ThomasFok/MegaFlash/kicad/rev1.0a/README.md

### Differences between Rev 1.0A and 1.0 PCB

- The 3.3V voltage regulator is removed. The bus transceiver is powered by Pico board.
- GPIO 8 and 9 of Pico (reserved for A2 and A3 address lines) are grounded.
- The shape of the board is rectangular.
