ThomasFok/MegaFlash/firmware/version.txt

Version 1.0.3 11-Nov-2026 (FWVERSION = $04)
- Fix: Add jmp instruction to xsetmou routine
- Fix: Boot Unidisk 3.5 from Boot Menu

Version 1.0.2 11-Jun-2026 (FWVERSION = $03)
- Fix: ProDOS Driver Status command returned wrong drive capacity

Version 1.0.1 08-Mar-2026 (FWVERSION = $02)
- Reduce memory usage in SLOTROM
- Jump to boot menu via swjmp routine
- Optimize readoneblock and writeoneblock routines
- Move dispatch to ROM1 segment
- Move getdib to ROM1 segment
- FPU: Unroll data transfer routine to improve performance

Version 1.0 13-Jul-2025 (FWVERSION = $01)
- First Public Release
- Switch to Main ROM bank when boot menu is executed.
