ThomasFok/MegaFlash/pico/version.txt

Version 1.1.12 04-Sep-2026
Pico Firmware
- Support ISSI Flash Chips
- Compiled with Pico SDK V2.3

Apple Firmware
- No changes (V1.0.2)

Version 1.1.11 18-May-2026
Pico Firmware
- Compiled with C17 and C++17 standard
- Support Alliance AS25F3512MQ flash chip
- When 6502 reads status register ($C0C0), the request is not forwarded to Pico CPU.
- Bug fix: TFTP failed to restart when blksize option from server is invalid

Apple Firmware
- No changes (V1.0.1)

Version 1.1.10 19-Mar-2026
Pico Firmware
- Fix a bug introduced in V1.1.9: Storage medium I/O error cannot be handled correctly during TFTP Transfer

Apple Firmware
- No changes (V1.0.1)

Version 1.1.9 17-Mar-2026
Pico Firmware
- Control Panel: Ask users to save settings when Esc key is pressed.
- TFTP Download: Convert DOS order image (.dsk or .do) to ProDOS order
- Bug Fix: NTP Update is executed twice when the machine is powered on
- Bug Fix: Memory Leak after TFTP Transfer

Apple Firmware
- No changes (V1.0.1)

Version 1.1.8 11-Mar-2026
Pico Firmware
- FSUB Applesoft BASIC FPU command is added
- Optimized Applesoft FPU routines
- Removed IRQ0 from RP2350 PIO program
- Overclocked RP2350 CPU to 225MHz

Apple Firmware (V1.0.1)
- Optimized disk access speed
- Optimized FPU speed

Version 1.1.7 20-Sep-2025
Pico Firmware
- Refactor flash.c and mediaaccess.c source code
- Source code clean up to reduce memory usage
- Improved some prompt messages in XModem Transfer
- RAM Disk has its own dedicated DMA channel

Apple Firmware
- No changes (V1.0)

Version 1.1.6 09-Sep-2025
Pico Firmware
- Optimized the timing of RP2350 PIO for compatibility with slower GAL16V8

Apple Firmware
- No changes (V1.0)

Version 1.1.5 25-Aug-2025
Pico Firmware
- ADTPro VSDRIVE drivers are included in ROM Disk

Apple Firmware
- No changes (V1.0)

Version 1.1.4 18-Aug-2025
Pico Firmware
- Abort Erase Flash Disk if Apple is reset during the process
- Minor clean up of source code

Apple Firmware
- No changes (V1.0)

Version 1.1.3 15-Aug-2025
Pico Firmware
- Bug Fix: Last ProDOS block may contain incorrect data when transferring disk image to PC via XMODEM-1k
- Minor changes to device information output
- Improved SPI reliability by adding NOP to enable/disable_spi0() function
- Changed Mutex in flash.c to Recursive Mutex
- Added Mutex to ramdisk.c
- Show CPU and SPI speed on Device Information Screen

Apple Firmware
- No changes (V1.0)

Version 1.1.2 11-Aug-2025
Pico Firmware
- Set the drive strength of SPI output pins to 8mA
- Set the drive strength of Flash Chips to 75%
- Hide the clock during drive erase in Control Panel
- Bug Fix: System freeze during TFTP Download since V1.1

Apple Firmware
- No changes (V1.0)

Version 1.1.1 04-Aug-2025
Pico Firmware
- Recompiled with PICO SDK V2.2.0
- Minor changes to Control Panel UI Wording
- Changed Pico PIO output pins from pull-down to pull-up for Rev1.1 PCB

Apple Firmware
- No changes (V1.0)

Version 1.1 30-Jul-2025
Pico Firmware
- Bug Fix: Failed to download to RAM Disk via WIFI/TFP
- Bug Fix: Failed to detect of IO Error when TFTP Download
- Improved SPI Interface Reliability
- Option to erase the entire drive when formatting through the Control Panel
- Each drive can be individually enabled/disabled

Apple Firmware
- No changes (V1.0)

Version 1.0 21-Jul-2025
- First Public Release
- Supported Winbond W25Q02JV-DTR flash chip
