ThomasFok/MegaFlash/kicad/rev1.2/bom-rev1.2.pdf

Reference | Value | Qty | Description | Manufacturer | Mfr Part No | Mouser Part No
C1,C2,C3,C4,C5,C6,C7,C8,C9 | 0.1uF | 9 | Ceramic Capacitor, 5mm Lead Spacing | Vishay | K104K15X7RF5WH5 | 594-K104K15X7RF5WH5
D1 | 1N5817 | 1 | 20V 1A Schottky Barrier Rectifier Diode, DO-41 | Vishay | 1N5817-E3/53 | 625-1N5817-E3/53
J1 | EXPSLOT | 1 | 2 Row Pin Header 2.54mm Pitch 19mm Length | Samtec | TSW-117-15-G-D | 200-TSW11715GD
R1,R2 | 100k | 2 | 100k 1/4W Through Hole Resistor
U1,U2 | 74LVC8T245 | 2 | Dual Supply Bus Transceiver, SOIC-24 | TI | SN74LVC8T245DWR | 595-SN74LVC8T245DWR
U3,U4,U5 | 74HC138 | 3 | Decoder 3 to 8 active low outputs | TI | SN74HC138QDRG4Q1 595-SN74HC138QDRG4Q1
U6 | Pico 2W | 1 | Raspberry Pi Pico 2W | Raspberry Pi
U7,U8 | W25Q01JVSF | 2 | SPI NOR Flash 1Gbit, SOIC-16 | Winbond | W25Q01JVSFIM | 454-W25Q01JVSFIM

Note: One Winbond W27C257 or W27E257 EEPROM is needed to replace the system ROM.
