ThomasFok/MegaFlash/kicad/rev1.0a/bom-rev1.0a.pdf

Reference | Value | Qty | Description | Manufacturer | Mfr Part No | Mouser Part No
C1,C2,C3,C4,C5,C6 | 0.1u | 6 | 0805 Ceramic Capacitor | KEMET | C0805C104M5RACTU | 80-C0805C104M5R
D1 | SS12 | 1 | 20V 1A Schottky Diode, SMA | Vishay | SS12-E3/61T | 625-SS12-E3
J1 | EXPSLOT | 1 | 2 Row Pin Header 2.54mm Pitch 19mm Length | Samtec | TSW-117-15-G-D | 200-TSW11715GD
RN1 | 100k | 1 | 4 resistor network, 4x0603 | Panasonic | EXB-V8V104JV | 667-EXB-V8V104JV
U1 | 74LVCH16T245DLR | 1 | 16-Bit Dual-Supply Bus Transceiver | T.I. | SN74LVCH16T245DLR | 595-SN74LVCH16T245LR
U2 | GAL16V8 | 1 | GAL16V8 PLCC-20 Package | Lattice
U3 | Pico | 1 | Raspberry Pi Pico 2W | Raspberry Pi
U4,U5 | W25Q01JVZE | 2 | 128MB NOR Flash, WSON-8 Package | Winbond | W25Q01JVZEIM E | 454-W25Q01JVZEIMTU

Note:
One Winbond W27C257 or W27E257 EEPROM is needed to replace the system ROM.
It is recommended to install a SMD PLCC-20 socket (Mouser part no: 540-88-020-17-400-TR) to U2.
