ThomasFok/MegaFlash/kicad/rev1.2/schematic-rev1.2.pdf

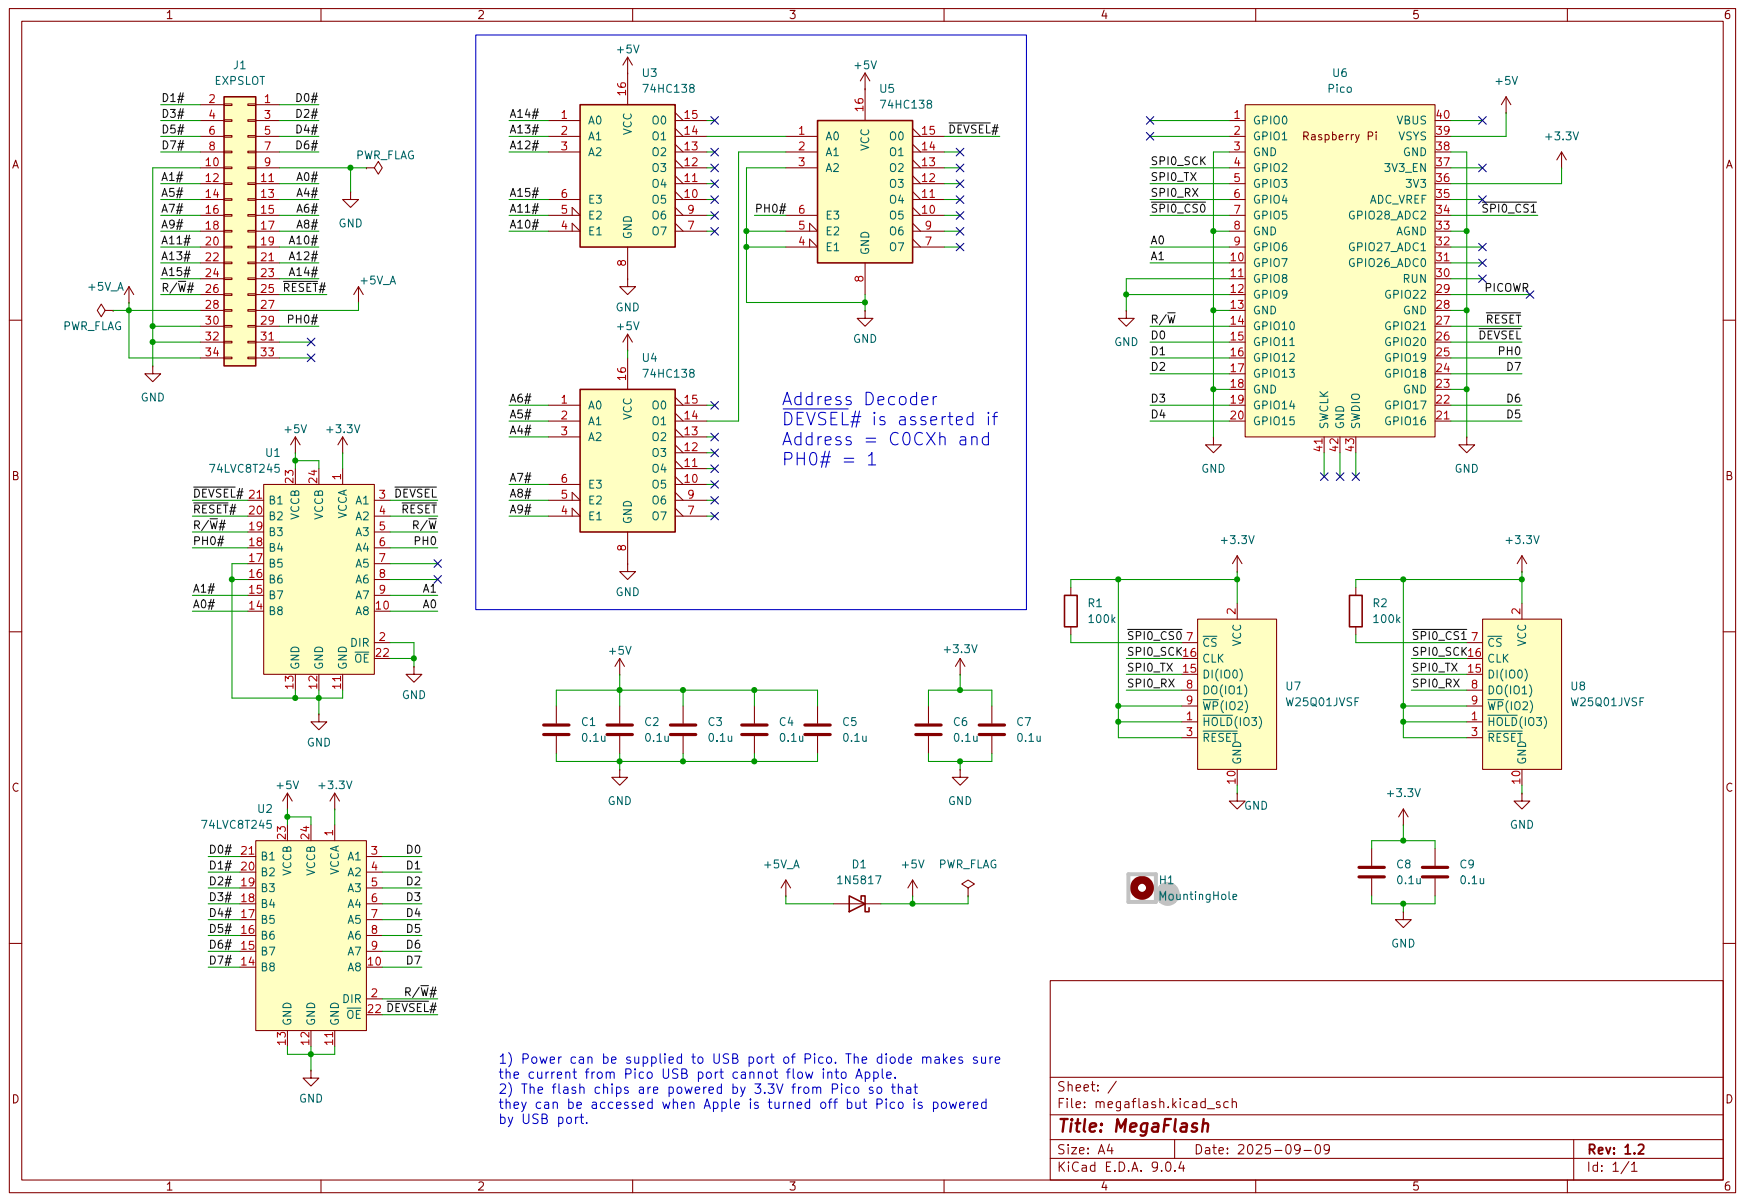
[picture p17: page 1]
