ThomasFok/MegaFlash/kicad/rev1.0a/schematic-rev1.0a.pdf

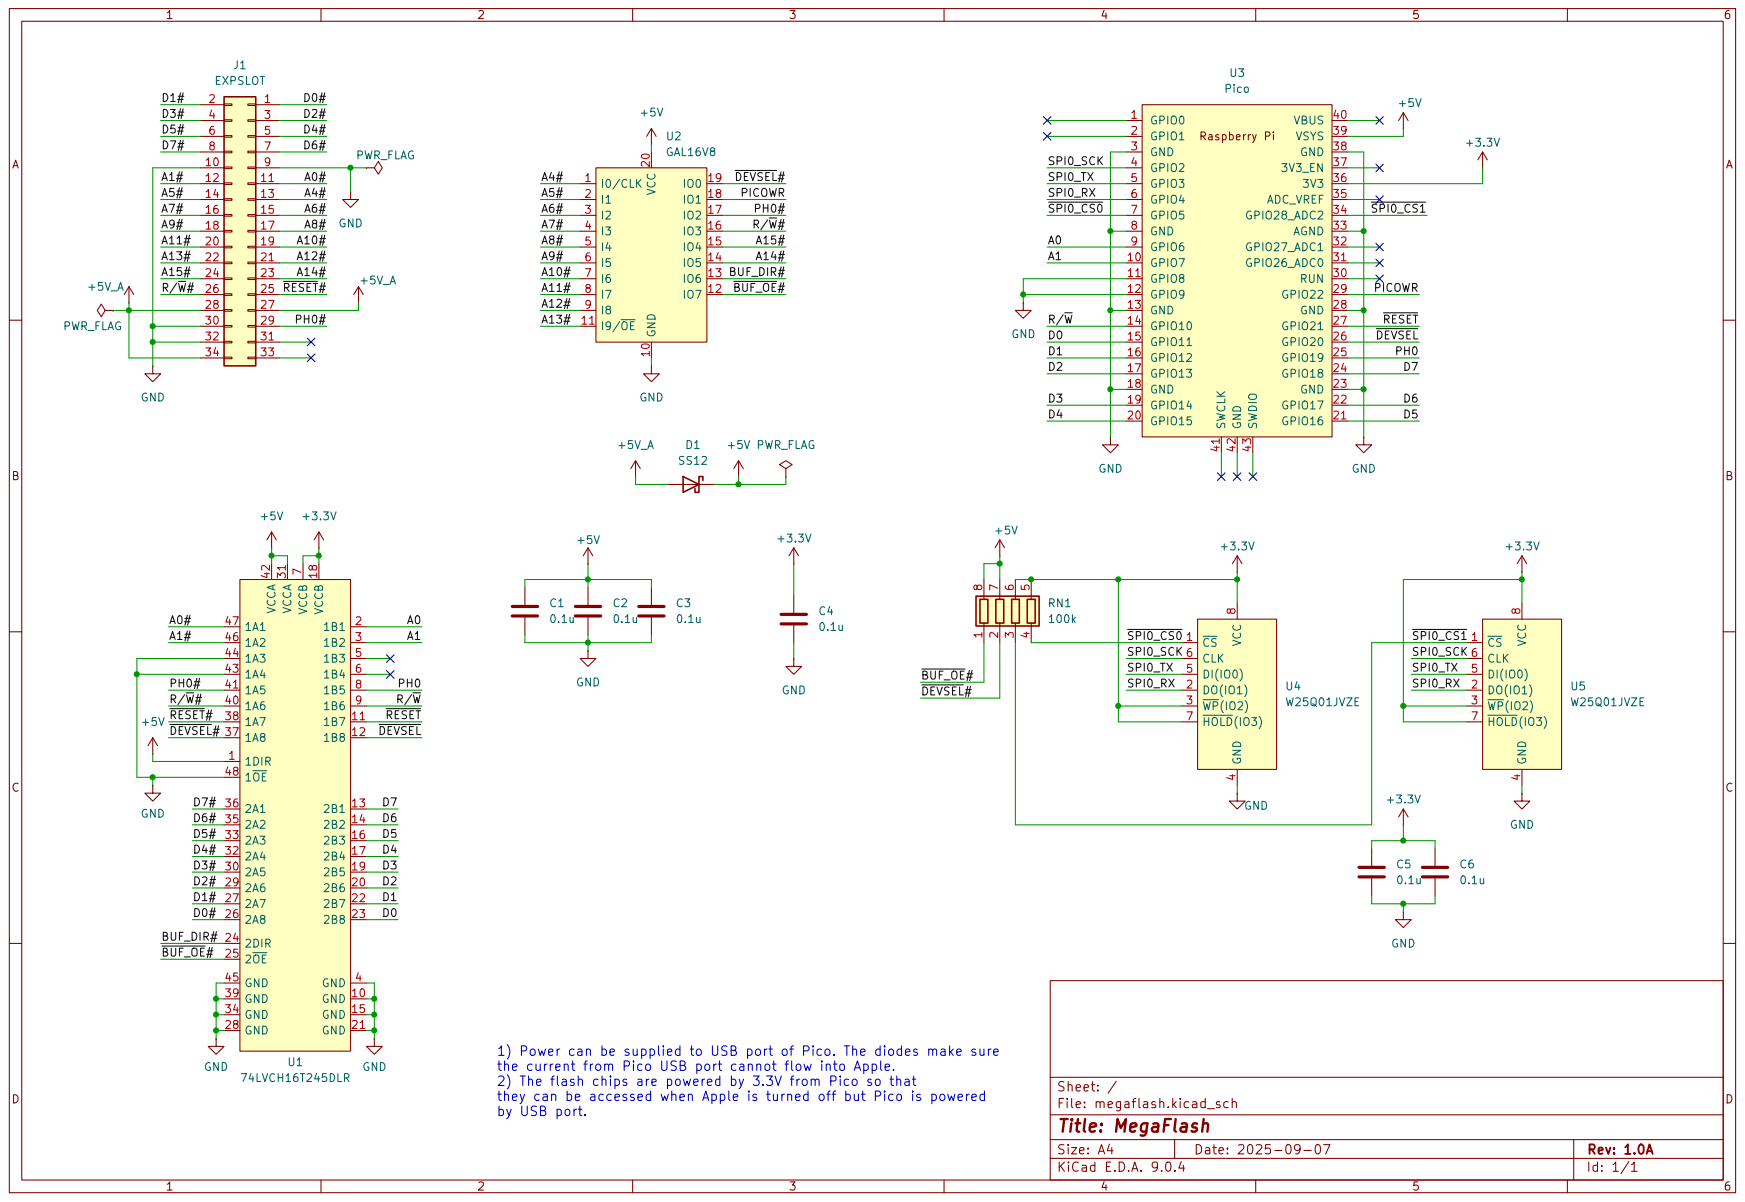
[picture p18: page 1]
