ThomasFok/MegaFlash/kicad/rev1.1b/schematic-rev1.1b.pdf

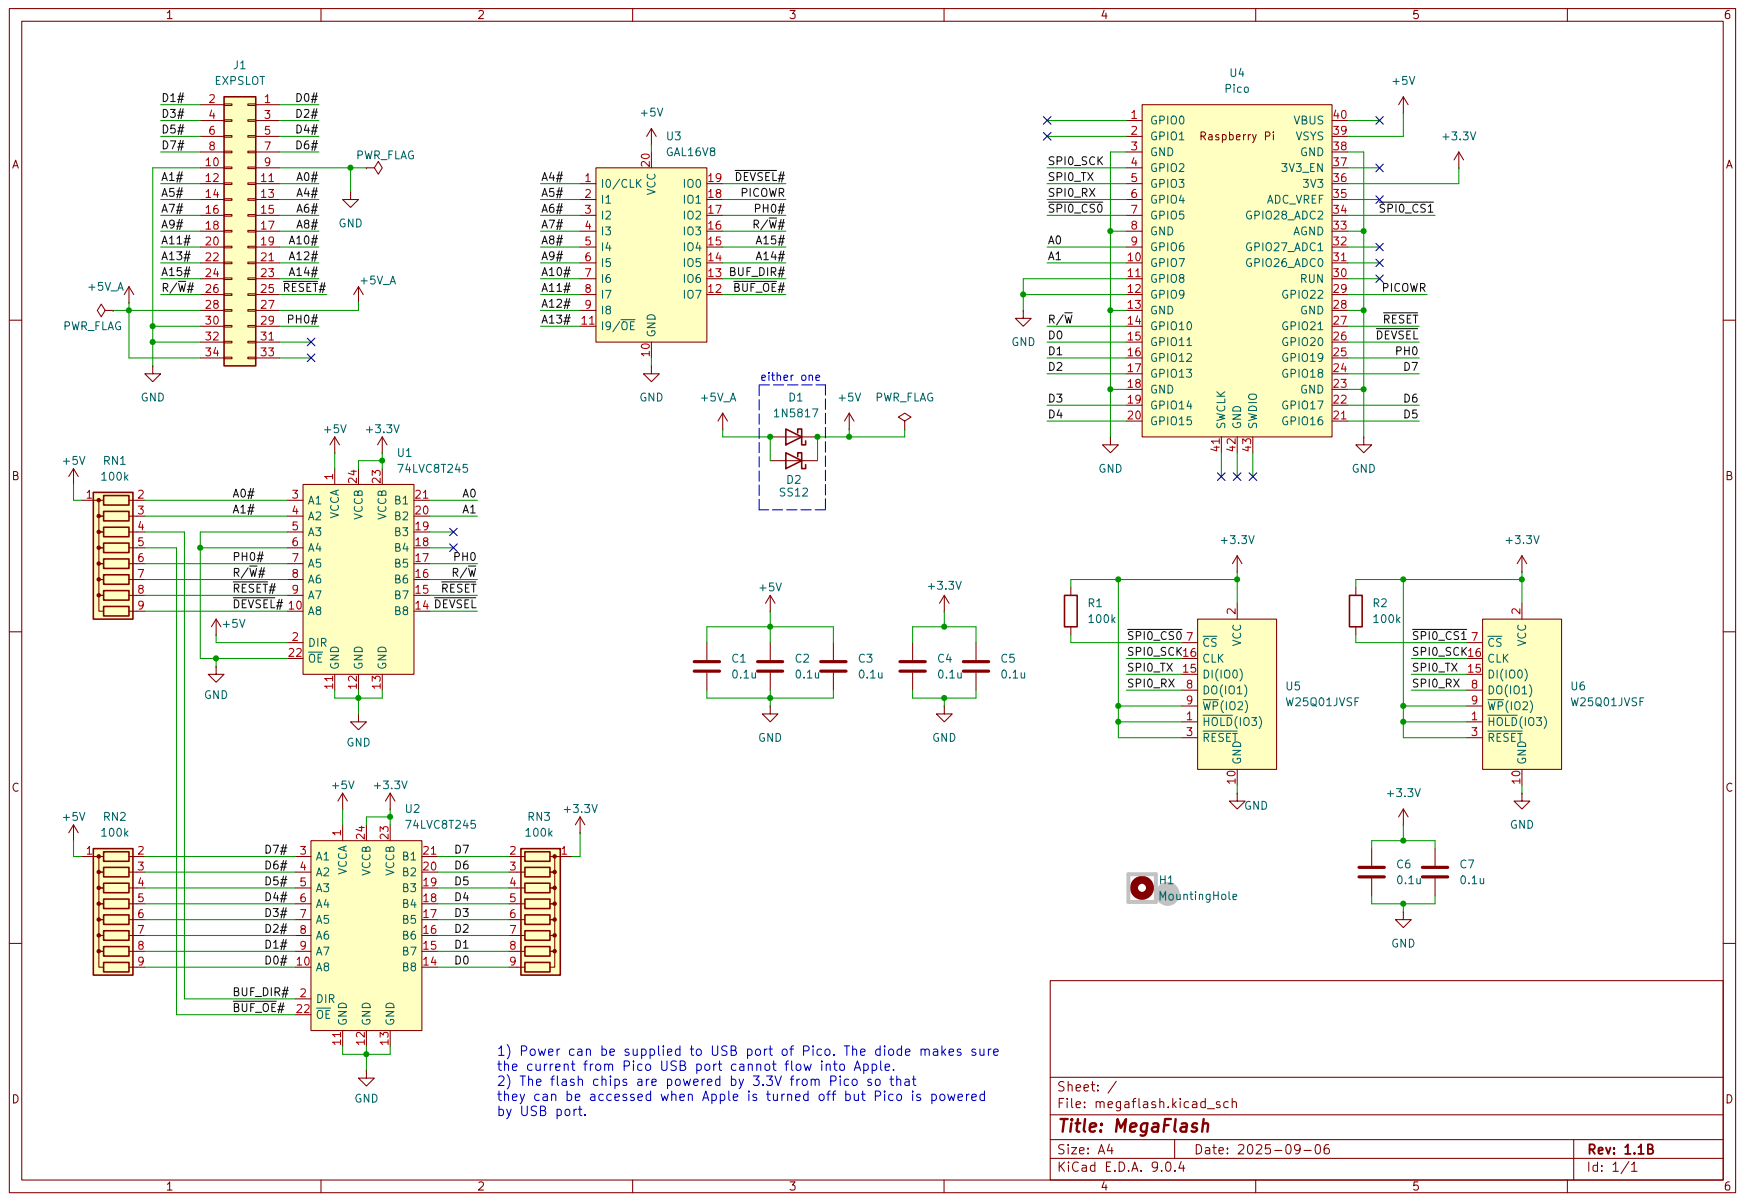
[picture p19: page 1]
