ThomasFok/MegaFlash/kicad/rev1.2/megaflash.kicad_pcb

## KiCad design kicad/rev1.2/megaflash.kicad_pcb (2026-05-17)

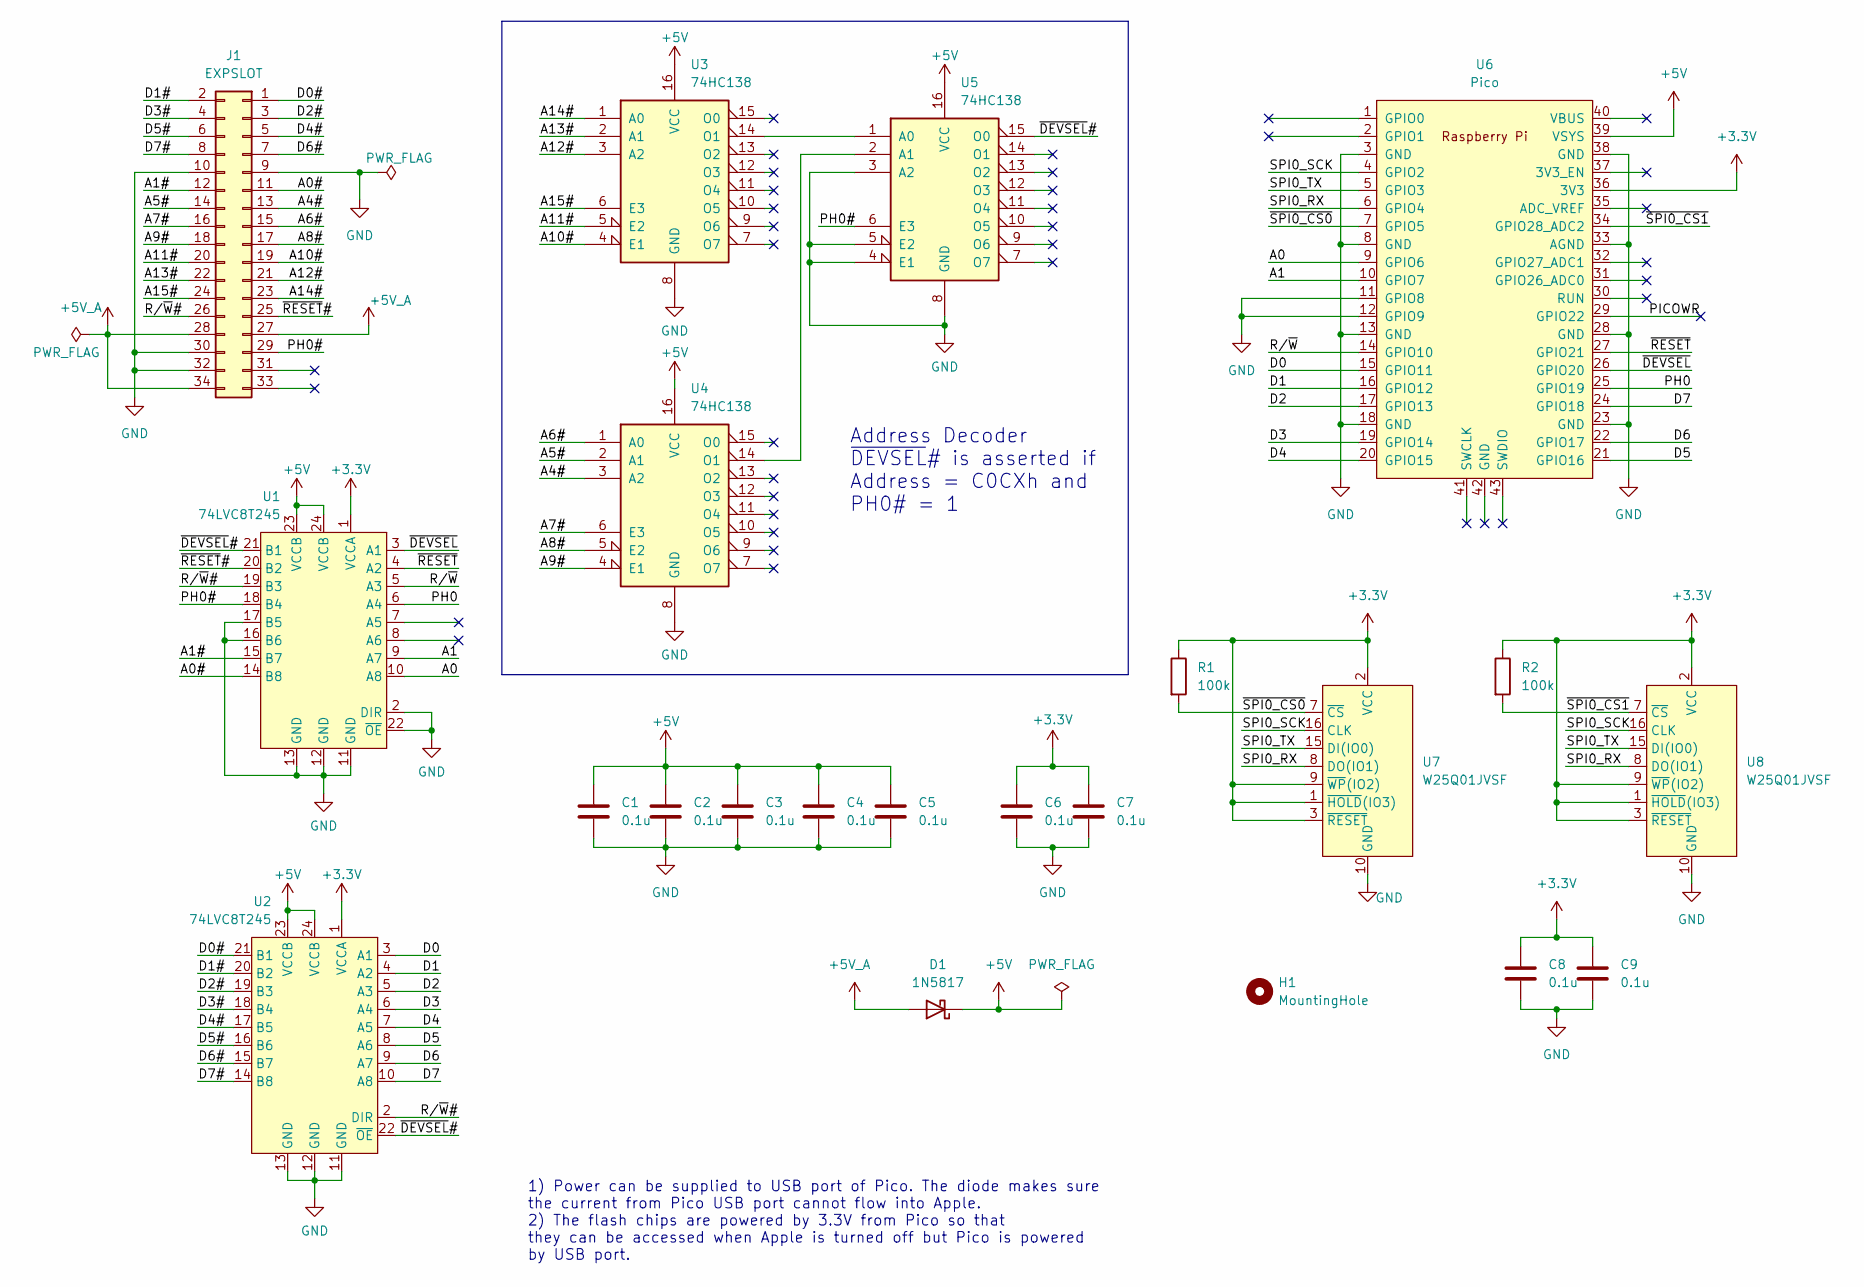
[picture p20: schematic megaflash.kicad_sch]

Parts:
C1, C2, C3, C4, C5, C6, C7, C8, C9: 0.1u; C_Disc_D5.1mm_W3.2mm_P5.00mm; Mouser Part No 594-K104K15X7RF5WH5
D1: 1N5817; D_DO-41_SOD81_P10.16mm_Horizontal; Mouser Part No 625-1N5817-E3/53
H1: MountingHole; MountingHole_2.7mm_M2.5
J1: EXPSLOT; PinHeader_2x17_P2.54mm_Vertical_Mirror; Mouser Part No 200-TSW11715GD
R1, R2: 100k; R_Axial_DIN0207_L6.3mm_D2.5mm_P10.16mm_Horizontal
U1, U2: 74LVC8T245; SOIC-24W_7.5x15.4mm_P1.27mm; Mfr Part No SN74LVC8T245DWR; Mouser Part No 595-SN74LVC8T245DWR
U3, U4, U5: 74HC138; SOIC-16_3.9x9.9mm_P1.27mm; Mouser Part No 595-SN74HC138QDRG4Q1
U6: Pico; RPi_Pico_SMD_NO_LABEL_NO_DEBUG
U7, U8: W25Q01JVSF; SOIC-16W_7.5x10.3mm_P1.27mm; Mouser Part No 454-W25Q01JVSFIM

Connections:
+3.3V: C6.1, C7.1, C8.1, C9.1, R1.1, R2.1, U1.1 (VCCA), U2.1 (VCCA), U6.36 (3V3), U7.1 (~HOLD(IO3)), U7.2 (VCC), U7.3 (~RESET), U7.9 (~WP(IO2)), U8.1 (~HOLD(IO3)), U8.2 (VCC), U8.3 (~RESET), U8.9 (~WP(IO2))
+5V: C1.1, C2.1, C3.1, C4.1, C5.1, D1.1 (K), U1.23 (VCCB), U1.24 (VCCB), U2.23 (VCCB), U2.24 (VCCB), U3.16 (VCC), U4.16 (VCC), U5.16 (VCC), U6.39 (VSYS)
+5V_A: D1.2 (A), J1.27, J1.28, J1.34
/A0: U1.10 (A8), U6.9 (GPIO6)
/A0#: J1.11, U1.14 (B8)
/A1: U1.9 (A7), U6.10 (GPIO7)
/A1#: J1.12, U1.15 (B7)
/A4#: J1.13, U4.3 (A2)
/A5#: J1.14, U4.2 (A1)
/A6#: J1.15, U4.1 (A0)
/A7#: J1.16, U4.6 (E3)
/A8#: J1.17, U4.5 (E2)
/A9#: J1.18, U4.4 (E1)
/A10#: J1.19, U3.4 (E1)
/A11#: J1.20, U3.5 (E2)
/A12#: J1.21, U3.3 (A2)
/A13#: J1.22, U3.2 (A1)
/A14#: J1.23, U3.1 (A0)
/A15#: J1.24, U3.6 (E3)
/D0: U2.3 (A1), U6.15 (GPIO11)
/D0#: J1.1, U2.21 (B1)
/D1: U2.4 (A2), U6.16 (GPIO12)
/D1#: J1.2, U2.20 (B2)
/D2: U2.5 (A3), U6.17 (GPIO13)
/D2#: J1.3, U2.19 (B3)
/D3: U2.6 (A4), U6.19 (GPIO14)
/D3#: J1.4, U2.18 (B4)
/D4: U2.7 (A5), U6.20 (GPIO15)
/D4#: J1.5, U2.17 (B5)
/D5: U2.8 (A6), U6.21 (GPIO16)
/D5#: J1.6, U2.16 (B6)
/D6: U2.9 (A7), U6.22 (GPIO17)
/D6#: J1.7, U2.15 (B7)
/D7: U2.10 (A8), U6.24 (GPIO18)
/D7#: J1.8, U2.14 (B8)
/PH0: U1.6 (A4), U6.25 (GPIO19)
/PH0#: J1.29, U1.18 (B4), U5.6 (E3)
/PICOWR: U6.29 (GPIO22)
/R/~W: U1.5 (A3), U6.14 (GPIO10)
/R/~W#: J1.26, U1.19 (B3), U2.2 (DIR)
/SPI0_RX: U6.6 (GPIO4), U7.8 (DO(IO1)), U8.8 (DO(IO1))
/SPI0_SCK: U6.4 (GPIO2), U7.16 (CLK), U8.16 (CLK)
/SPI0_TX: U6.5 (GPIO3), U7.15 (DI(IO0)), U8.15 (DI(IO0))
/~DEVSEL: U1.3 (A1), U6.26 (GPIO20)
/~DEVSEL#: U1.21 (B1), U2.22 (~OE), U5.15 (O0)
/~RESET: U1.4 (A2), U6.27 (GPIO21)
/~RESET#: J1.25, U1.20 (B2)
/~SPI0_CS0: R1.2, U6.7 (GPIO5), U7.7 (~CS)
/~SPI0_CS1: R2.2, U6.34 (GPIO28_ADC2), U8.7 (~CS)
GND: C1.2, C2.2, C3.2, C4.2, C5.2, C6.2, C7.2, C8.2, C9.2, J1.9, J1.10, J1.30, J1.32, U1.2 (DIR), U1.11 (GND), U1.12 (GND), U1.13 (GND), U1.16 (B6), U1.17 (B5), U1.22 (~OE), U2.11 (GND), U2.12 (GND), U2.13 (GND), U3.8 (GND), U4.8 (GND), U5.3 (A2), U5.4 (E1), U5.5 (E2), U5.8 (GND), U6.3 (GND), U6.8 (GND), U6.11 (GPIO8), U6.12 (GPIO9), U6.13 (GND), U6.18 (GND), U6.23 (GND), U6.28 (GND), U6.33 (AGND), U6.38 (GND), U7.10 (GND), U8.10 (GND)
unnamed: U3.14 (O1), U5.1 (A0)
unnamed: U4.14 (O1), U5.2 (A1)

Notes on the sheet:
Address Decoder ~{DEVSEL}# is asserted if Address = C0CXh and PH0# = 1
1) Power can be supplied to USB port of Pico. The diode makes sure the current from Pico USB port cannot flow into Apple. 2) The flash chips are powered by 3.3V from Pico so that they can be accessed when Apple is turned off but Pico is powered by USB port.

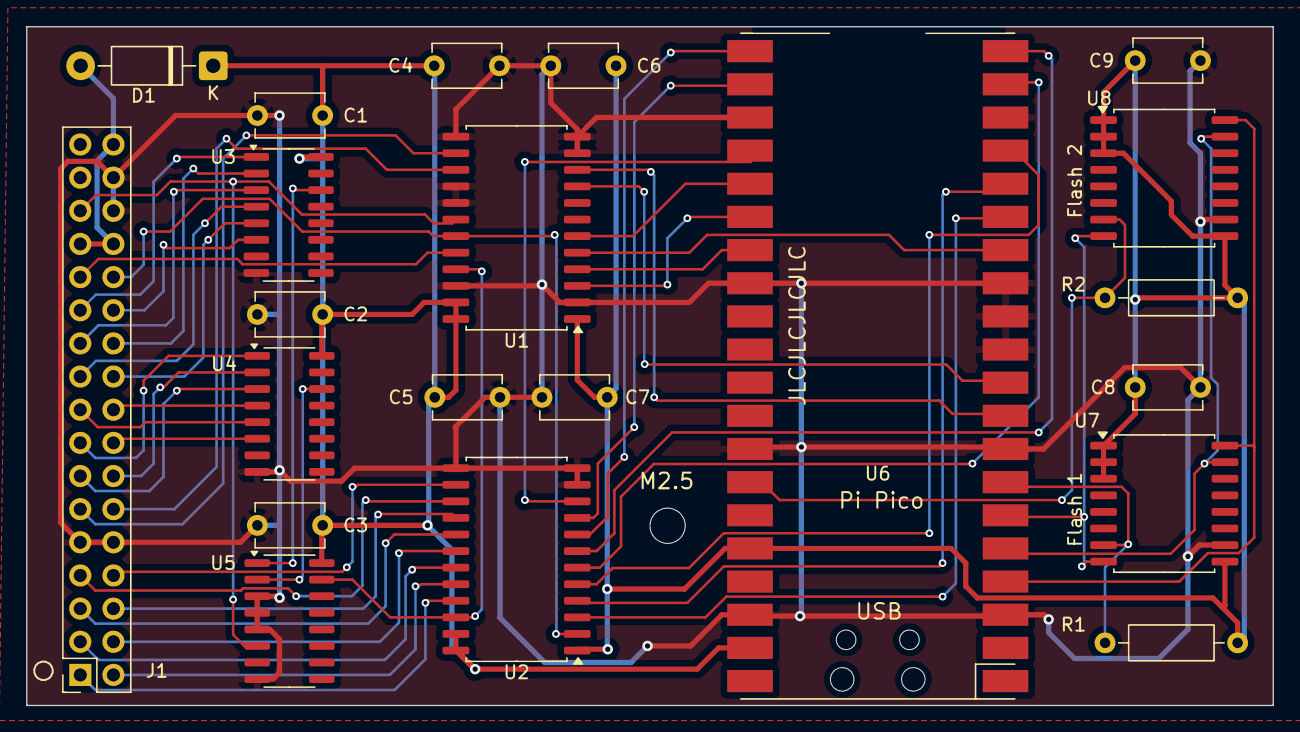
[picture p21: board megaflash.kicad_pcb from above]

Board: 2 copper layers, 95.5 x 52.0 mm, 22 parts (0 on the bottom side), 51 nets.
