ThomasFok/MegaFlash/pico/busloop.c

#include "pico/stdlib.h"
#include "a2bus.h"
#include "defines.h"
#include "busloop.h"
#include "cmdhandler.h"

//--------------------------------------------------------------------
//Accessing buffers from Apple IIc
//The parameter buffer and data buffer can be accessed from address
//$C0C1 and $C0C2. There are internal address pointers in MegaFlash.
//When those addresses are accessed, the pointers advance by one
//automatically. When end of buffer is reached, the pointer loop around
//to the begining of the buffer.
//
//Interleaved Mode
//================
//The data buffer is mainly for storing ProDOS data block. The block is 512 bytes
//long, which is two 6502 pages.To access the buffer, read/write loop
//has to be executed twice.
//
//To reduce the loop overhead, interleaved mode is provided for Data Buffer.
//In this mode, the buffer is divided into two parts, $00-$FF and $100-$1FF.
//When the lower part is accessed, the pointer jumps to the same offset of
//of upper part. When the upper part is accessed, it jumps to next offset of
//lower part.
//
//i.e. The sequence of the pointer is
//
// $0 -> $100 -> $1 -> $101 -> $2 ->$102 -> ... -> $FF ->$1FF -> $0
//
//With interleaved mode, there are two memory accesses in each loop iteration and
//loop overhead can be reduced.
//
//This sequence can be generated by this expression:
//  (dataBufferIndex&0x100)?(dataBufferIndex+1)&0xff:dataBufferIndex|0x100;
//
//Important:
// Switching to interleaved mode should be temporary. The mode should be restored
// to linear after data transfer.
//-----

//---------------------------------------------------------------------
//Mega Flash Registers at $C0C0-C0CF
//We can have up to 16 registers if A2 and A3 address lines are connected.
//The 16 registers are divided into 4 chunks. Each PIO state machine is
//responsible for 4 registers. e.g. State machine 0 is responsible for
//$C0C0-$C0C4.
__attribute__((aligned(4))) union {
  uint8_t  r[16];     //Individual 8-bit registers
  uint32_t i32[4];    //Chunks of 4 32-bit registers
} registers;
//---------------------------------------------------------------------

//---------------------------------------------------------------------
// Parameter / Data Buffers
uint parameterBufferIndex;
uint dataBufferIndex;
uint8_t __attribute__((aligned(4))) parameterBuffer[PARAMBUFFERSIZE]; 
uint8_t __attribute__((aligned(4))) dataBuffer[DATABUFFERSIZE];
transfermode_t dataBufferTransferMode;  //Linear or Interleaved mode
//---------------------------------------------------------------------


////////////////////////////////////////////////////////////////////
// Initialize Bus Loop data
//
void BusLoopDataInit() { 
  //Switch PIO program from Slinky to Native mode
  PioSwitchToNativeMode();

  parameterBufferIndex = 0;
  dataBufferIndex = 0;
  dataBufferTransferMode = DEFAULTTRANSFERMODE;

  registers.r[IDREG] = IDREG_VAL;
  registers.r[STATUSREG]=0;
  registers.r[PARAMREG]=parameterBuffer[0];
  registers.r[DATAREG]=dataBuffer[0];
  registers.i32[1] = 0;
  registers.i32[2] = 0;  
  registers.i32[3] = 0; 
  
  //Send MegaFlash Registers to PIO
  UpdateMegaFlashRegisters(0,registers.i32[0]);
  UpdateMegaFlashRegisters(1,registers.i32[1]);
  UpdateMegaFlashRegisters(2,registers.i32[2]);  
  UpdateMegaFlashRegisters(3,registers.i32[3]);
}

////////////////////////////////////////////////////////////////////
// MegaFlash Bus Loop
//
// Process bus access from Apple II.
// The GetAppleBusBlocking() function waits for bus access from Apple II.
// When it happens, the function sends back the bus access data.
// It includes 4-bit address, 1 bit RnW Flag and 8-bit data for write access.
// The 4-bit address indicates which I/O register is being accessed ($C0C0-$C0CF)
//
// To update the I/O register output value, put the value to registers union.
// For example, to change register $C0C2 to $12. Write $12 to register.r[02].
// The UpdateMegaFlashRegisters() function call at the end of this function
// send updated values to PIO.
//
void __no_inline_not_in_flash_func(BusLoop)() {
  const uint32_t READFLAG = (1<<4); //Read flag is at bit 4

  while(true) {
    //8-bit data from Apple + RnW Flag + 4-bit address from Apple
    const uint32_t busdata = GetAppleBusBlocking();
    const uint32_t addr = busdata & 0b1111;     //Lower nibble of Apple Address

    if (busdata & READFLAG) {
      //
      //6502 is reading from us
      //
      switch(addr) {
        case STATUSREG:
          continue; //No need to update MegaFlsh Registers
        case DATAREG:
          //advance dataBufferIndex
          if (dataBufferTransferMode==MODE_LINEAR) dataBufferIndex = (dataBufferIndex + 1) & DATABUFFERINDEXMASK; //loop around if end of buffer is reached
          else dataBufferIndex = (dataBufferIndex&0x100)?(dataBufferIndex+1)&0xff:dataBufferIndex|0x100;
          
          registers.r[DATAREG] = dataBuffer[dataBufferIndex];
          break;
        case PARAMREG:
          parameterBufferIndex = (parameterBufferIndex + 1) & PARAMBUFFERINDEXMASK; //loop around if end of buffer is reached
          registers.r[PARAMREG] = parameterBuffer[parameterBufferIndex];
          break;        
        case IDREG: 
          registers.r[IDREG] = ~registers.r[IDREG];  //Bitwise NOT
          break;          
        default:
          continue; //No need to update MegaFlash Registers if reading other addresses
      }
      
    } else {
        //
        //6502 is writing to us
        //
        const uint32_t data = (busdata >>5) & 0xff; //8-bit data from Apple
        
        switch(addr) {
          case CMDREG:
            //Set Busy Flag
            registers.r[STATUSREG] |= BUSYFLAG;
            
            //Send Busy Flag to PIO State Machine immediately
            UpdateMegaFlashRegisters(0, registers.i32[0]);

            //Execute the command
            DoCommand(data);
            
            //Clear Busy Flag
            registers.r[STATUSREG] &= ~BUSYFLAG;
            break;
          case DATAREG:
            dataBuffer[dataBufferIndex] = data;
            
            //advance dataBufferIndex
            if (dataBufferTransferMode==MODE_LINEAR) dataBufferIndex = (dataBufferIndex + 1) & DATABUFFERINDEXMASK; //loop around if end of buffer is reached
            else dataBufferIndex = (dataBufferIndex&0x100)?(dataBufferIndex+1)&0xff:dataBufferIndex|0x100;
            
            registers.r[DATAREG] = dataBuffer[dataBufferIndex];
            break;
          case PARAMREG:
            parameterBuffer[parameterBufferIndex] = data;
            parameterBufferIndex = (parameterBufferIndex + 1) & PARAMBUFFERINDEXMASK;
            registers.r[PARAMREG] = parameterBuffer[parameterBufferIndex];
            break;      
          case IDREG:
            break;    //Do nothing. IDREG is not writable.
          default:
            //$C0C4-$C0CF behave like RAM
            registers.r[addr]=data;
            break;
      } 
    } 
    
    //Update MegaFlash I/O registers
    UpdateMegaFlashRegisters(0,registers.i32[0]);
    UpdateMegaFlashRegisters(1,registers.i32[1]);
    UpdateMegaFlashRegisters(2,registers.i32[2]);
    UpdateMegaFlashRegisters(3,registers.i32[3]);    
  }//while  
}
