ThomasFok/MegaFlash/pico/udptask.h

#ifndef _UDPTASK_H
#define _UDPTASK_H

#include "pico/stdlib.h"
#include "pico/cyw43_arch.h"
#include "debug.h"
#include "ringqueue.h"
#include <memory>

static constexpr uint32_t DEFAULT_DNSTIMEOUT = 5000;    //DNS timeout in msec
static constexpr uint32_t UDP_BUFFERSIZE = 1500;        //UDP Packet Buffer Size
static constexpr uint32_t HEARTBEAT_PERIOD = 50;        //Execute event loop every HEARTBEAT_PERIOD in msec
static constexpr uint32_t WATCHDOG_TIMEOUT = (10*1000); //Watchdog Timer timeout in msec
static constexpr size_t   PACKETQUEUE_SIZE = 8;         //Rx Packet Queue Capacity

#define TIMEOUT_NEVER at_the_end_of_time
enum {
  DNSERR_TIMEOUT     = -1,
  DNSERR_NONE        =  0,
  DNSERR_INVALIDHOST =  1
};

//A helper struct to hold the custom deleter function of struct pbuf*
struct pbuf_deleter_t {
	void operator()(struct pbuf* pbuf) 	{
    if (pbuf != nullptr) {
      cyw43_arch_lwip_begin();
      pbuf_free(pbuf);
      cyw43_arch_lwip_end();
    }    
	}
};

//unique_ptr of struct pbuf* with custom deleter
using unique_ptr_pbuf_t = std::unique_ptr<struct pbuf, pbuf_deleter_t>;

//Encapsulate a received UDP packet
struct RxPacket {
	RxPacket() {}
	explicit RxPacket(unique_ptr_pbuf_t& pbuf, ip_addr_t remoteipaddr, uint16_t remoteport)
		:rxpbuf(std::move(pbuf)), rxremoteipaddr(remoteipaddr), rxremoteport(remoteport) {}
    
	//Disallow Copying since unique_ptr is not copyable
	RxPacket(const RxPacket& other) = delete;
	RxPacket& operator=(const RxPacket& other) = delete;

	//Move Constructor and Assignment
	RxPacket(RxPacket&& other) = default;
	RxPacket& operator=(RxPacket&& other) = default;

	unique_ptr_pbuf_t rxpbuf;
	ip_addr_t rxremoteipaddr;
	uint16_t  rxremoteport;
};

//PakcetQueue typedef
using PacketQueue = ringqueue<RxPacket, PACKETQUEUE_SIZE>;

class CUDPTask {
public:
  //Constants
  static const uint32_t WIFI_COUNTRY = CYW43_COUNTRY_WORLDWIDE;
  static const int WIFI_MAX_ATTEMPT = 3;

  //Error Code 0-15 is reserved for CUDPTask
  static const int ERR_NONE       = 0;
  static const int ERR_NOTPICOW   = 1;
  static const int ERR_SSIDNOTSET = 2;
  static const int ERR_NONET      = 3;        //No matching SSID
  static const int ERR_BADAUTH    = 4;        //Authentication Problem
  static const int ERR_NOIP       = 5;        //DHCP problem
  static const int ERR_WIFINOTCONNECTED = 6;  //Other Problems
  static const int ERR_CONNECTIONLOST   = 7;  //WIFI is disconnect during the process
  static const int ERR_DNSINVALIDHOST   = 8;  //Hostname is invalid or does not exist
  static const int ERR_DNSTIMEOUT       = 9;  //Timeout during DNS Lookup
  static const int ERR_WATCHDOG         = 10; //Watchdog Timer timeout
  static const int ERR_ABORTED          = 11; //Aborted by request
  
  //Error Code 16-31 is for subclass
  static const int ERR_SUBCLASS_BEGIN  = 16;

  //Constructor and Destructor
  CUDPTask();
  virtual ~CUDPTask();  /* must be virtual since this is a base class */

  //Disallow copying
  CUDPTask(const CUDPTask&) = delete;
  CUDPTask& operator=(const CUDPTask& ) = delete;

  //Public Methods
  virtual void Run(const char* ssid, const char* wpakey);

  //Getter methods
  bool GetWifiConnected() const {return this->wifiConnected;}
  bool GetServerIpResolved() const {return this->serverIpResolved;}
  ip_addr_t GetServerAddr() const {return this->server_addr;}
  bool GetCompleted() const {return this->completed;}
  
  //Declare callback functions as friend
  friend void dns_callback(const char *hostname, const ip_addr_t *ipaddr, void *arg);
  friend void udp_recv_callback(void *arg, struct udp_pcb *pcb, struct pbuf *pbuf, const ip_addr_t *remote_addr, u16_t remote_port);
  
protected:
  void InitCyw43();
  bool hasInitedCyw43;
  
  //
  // Wifi Connection
  //
  void ConnectWifi(const char* ssid, const char* wpakey);
  bool wifiConnected;     //To indicate WIFI is connected

  //
  // DNS
  //
  void DNSLookup(const char* hostname,const uint32_t timeout=DEFAULT_DNSTIMEOUT);
  absolute_time_t dnsTimeout;
  ip_addr_t server_addr;  //Sever IP Address
  bool serverIpResolved;  //To indicate Server IP Addr is resolved
  //To recevie result from DNS Callback
  bool dnsCallbackInvoked;
  int dns_error;
  ip_addr_t dns_result_ipaddr;


  //
  //UDP Send/Receive
  //
  void SendUDP(const uint8_t *payload,const uint16_t len, const uint16_t port);
  struct udp_pcb *pcb;
  //To receive result from UDP Callback
  PacketQueue packetQueue; //Queue to store received UDP packets
  uint8_t *rxbuffer;        //buffer to store UDP packet payload


  //
  //Timer
  //
  void SetTimer(const uint32_t timeout, const uint32_t arg=0);
  void CancelTimer() {timerTimeout = TIMEOUT_NEVER;}
  absolute_time_t timerTimeout;
  uint32_t timerArg;

  //
  //Completion
  //
  virtual void Complete();
  bool completed;

  //Event Handlers
  virtual void EvtStart();
  virtual void EvtDNSResult(const int dnserr, const ip_addr_t *ipaddr);
  virtual void EvtUDPReceived(const uint8_t* payload,uint16_t payloadlen,ip_addr_t remote_addr,uint16_t remote_port);
  virtual void EvtTimeout(uint32_t arg);
  virtual void EvtConnectionLost();
  virtual bool EvtAbortRequested();
  virtual void EvtAborted();
  virtual void EvtWatchdogTimeout();
    
private:
  //
  // Watchdog
  //
  absolute_time_t watchdogTimeout;
  void WatchdogUpdate() {
    watchdogTimeout = make_timeout_time_ms(WATCHDOG_TIMEOUT);
  }
      
  //
  // static members
  //
public:  
  static const char* GetErrorCodeMessage(const int error);  //Translate error code to error message for debug
  static CUDPTask* GetRunningObject() {return runningObject;}
  static bool IsRunning() {return CUDPTask::isRunning;}     //Is a CUDPTask running?
  static bool IsAbortRequested() {return CUDPTask::abortRequested;}
  static void RequestAbortIfRunning() {
    if (!IsRunning()) return;
    else {
      INFO_PRINTF("Abort Requested\n");
      abortRequested = true;
    }
  }
    
    
  //////////////////////////////////////////////////////////////////////
  //Abort Request from another core
  //
  //This method is called by another core to abort the running task.
  //If no task is running, return true immediately.
  //Else try to abort the task by setting abortRequested to true.
  //Then, wait the task to be aborted with a timeout.
  //If the task is aborted, return true.
  //If timeout, return false.
  static bool AbortTimeout_ms(const uint32_t timeout_ms) {
    if (!IsRunning()) return true;
    else {
      INFO_PRINTF("Abort Requested\n");
      abortRequested = true;
    }      
    absolute_time_t until = make_timeout_time_ms(timeout_ms);
    do {
      if (!IsRunning()) return true;
      sleep_ms(1);
    }while(!time_reached(until));
    return false; //timeout
  }
    
protected:
  static CUDPTask *runningObject;
  static volatile bool isRunning;       //To indicate a CUDPTask is running  
  static volatile bool abortRequested;
  
  //This method is called when abortRequested is set to true.
  //It calls EvtAbortedRequested() method of the running task
  //If it returns true, it aborts the task by throwing ERR_ABORTED.
  static void Abort(CUDPTask* p) {                 //Try to abort
    bool proceed = p->EvtAbortRequested();         //Ask if to proceed the abort request
    CUDPTask::abortRequested = false;
    if (proceed) {
      p->EvtAborted();
      throw CUDPTask::ERR_ABORTED;
    }
  }

};


#endif
