ThomasFok/MegaFlash/(commit log)

2025-09-05 PCB Rev 1.1A images
2025-09-05 Remove rev1.1 PCB
    [megaflash-B_Cu.gbl, megaflash-B_Mask.gbs, megaflash-B_Paste.gbp, megaflash-B_Silkscreen.gbo, megaflash-Edge_Cuts.gm1, megaflash-F_Cu.gtl, megaflash-F_Mask.gts, megaflash-F_Paste.gtp]
2025-09-05 Added Rev1.1A PCB
    [megaflash-B_Cu.gbl, megaflash-B_Mask.gbs, megaflash-B_Paste.gbp, megaflash-B_Silkscreen.gbo, megaflash-Edge_Cuts.gm1, megaflash-F_Cu.gtl, megaflash-F_Mask.gts, megaflash-F_Paste.gtp]
2025-09-05 Removed Rev1.1a PCB
    [megaflash-B_Cu.gbl, megaflash-B_Mask.gbs, megaflash-B_Paste.gbp, megaflash-B_Silkscreen.gbo, megaflash-Edge_Cuts.gm1, megaflash-F_Cu.gtl, megaflash-F_Mask.gts, megaflash-F_Paste.gtp]
2025-09-05 Rev 1.1b PCB
    [megaflash-B_Cu.gbl, megaflash-B_Mask.gbs, megaflash-B_Paste.gbp, megaflash-B_Silkscreen.gbo, megaflash-Edge_Cuts.gm1, megaflash-F_Cu.gtl, megaflash-F_Mask.gts, megaflash-F_Paste.gtp]
2025-09-05 Revised Rev1.1b PCB
    [megaflash-B_Cu.gbl, megaflash-B_Mask.gbs, megaflash-B_Paste.gbp, megaflash-B_Silkscreen.gbo, megaflash-Edge_Cuts.gm1, megaflash-F_Cu.gtl, megaflash-F_Mask.gts, megaflash-F_Paste.gtp]
2025-09-06 Revised PCB Rev 1.1B
    [megaflash-B_Cu.gbl, megaflash-B_Mask.gbs, megaflash-B_Paste.gbp, megaflash-B_Silkscreen.gbo, megaflash-Edge_Cuts.gm1, megaflash-F_Cu.gtl, megaflash-F_Mask.gts, megaflash-F_Paste.gtp]
2025-09-07 Rev 1.0A PCB
    [megaflash-B_Cu.gbl, megaflash-B_Mask.gbs, megaflash-B_Paste.gbp, megaflash-B_Silkscreen.gbo, megaflash-Edge_Cuts.gm1, megaflash-F_Cu.gtl, megaflash-F_Mask.gts, megaflash-F_Paste.gtp]
2025-09-07 Updated schematic
    [megaflash.kicad_sch]
2025-09-13 Added PCB Assembly Notes
2025-09-19 Removed DMA usage from romdisk.c
2025-09-19 Ramdisk has its own dedicated DMA channel
2025-09-19 Removed unnecessary DMA access
2025-09-19 Show heap usage in Device Information
2026-02-21 Corrected typos and code clean up
    [fpu.c]
2026-02-22 Added comment about SPI mode
2026-02-22 Reduced memory usage in SLOTROM segment
2026-02-24 Updated comments
    [iic.cfg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]
2026-02-26 Corrected the description of SPI mode
    [flash.c]
2026-03-02 Added comment on RX DMA Channel
2026-03-03 Renamed Timer commands to Stopwatch
2026-03-05 Optimized DMA routines
2026-03-06 Bug fix: correct output when d==0
    [fpu.c]
2026-03-06 StoreResult() writes sign bit to correct location
    [fpu.c]
2026-03-06 Assigned FPU segment to address
    [iic.cfg, merge_iic.cfg, merge_iicp.cfg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]
2026-03-07 Added fswrts routine to improve performance on IIc+
    [iic.cfg, merge_iic.cfg, merge_iicp.cfg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]
2026-03-09 Increase core voltage to 1.15V when overclock
2026-03-11 Fix: ReadFromFlashByDMA() hangs when CPU is overclocked
    [flash.c]
2026-03-12 When Esc key is pressed from main menu, ask user to save the settings before exiting
2026-03-14 Fix: NTP is updated twice when power on
    [main.c]
2026-03-14 Avoid race condition with TFTP server
    [tftptxtask.cpp]
2026-03-24 Added CLAMP macro
2026-03-27 Device Info shows GCC Version
2026-04-25 Replaced std::queue with a ring buffer
    [ringqueue.h, udptask.cpp, udptask.h]
2026-04-26 Fix: TFTP failed to restart when blksize option from server is invalid.
    [tftptxtask.cpp, tftptxtask.h]
2026-05-17 Revision 1.2 PCB
    [megaflash-B_Cu.gbl, megaflash-B_Mask.gbs, megaflash-B_Paste.gbp, megaflash-B_Silkscreen.gbo, megaflash-Edge_Cuts.gm1, megaflash-F_Cu.gtl, megaflash-F_Mask.gts, megaflash-F_Paste.gtp]
2026-05-18 Pico Firmware V1.1.11
2026-06-11 Fix: ProDOS Driver Status command returned wrong drive capacity.
2026-06-12 Slot number is configurable.
2026-09-03 Handling of Esc key
2026-09-03 Updated pcbassemblynotes.pdf
